zeezooX/Deshret/README.md

# Deshret
A micromouse running on a STM32 with very small dimensions and weight, and high speed and maneuverability. Its objective is to solve micromouse mazes autonomously.

## Images
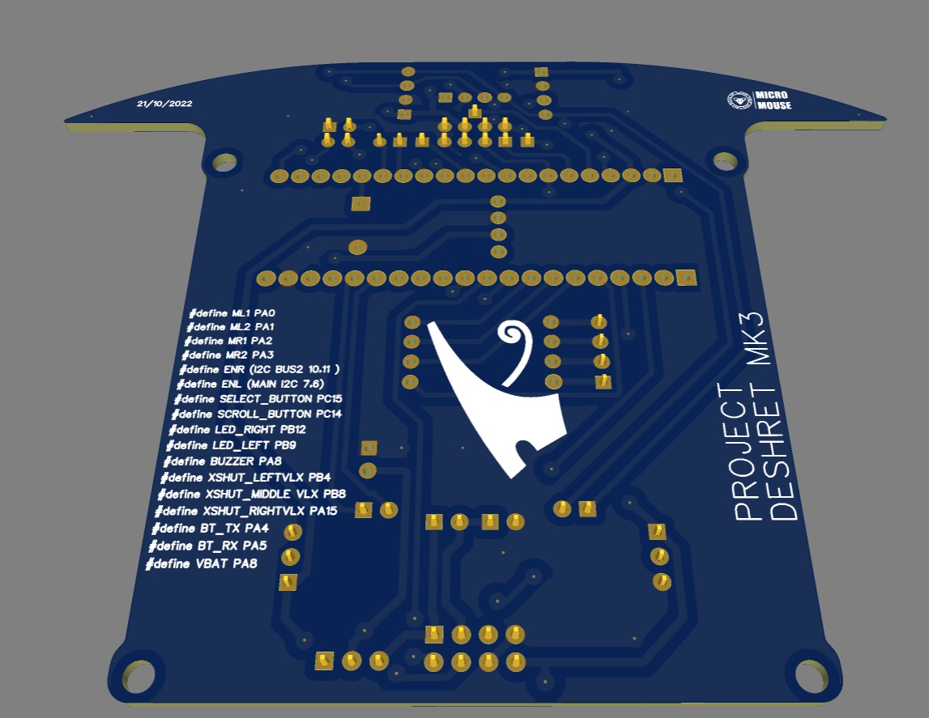
[picture p1: img/1.jpg]

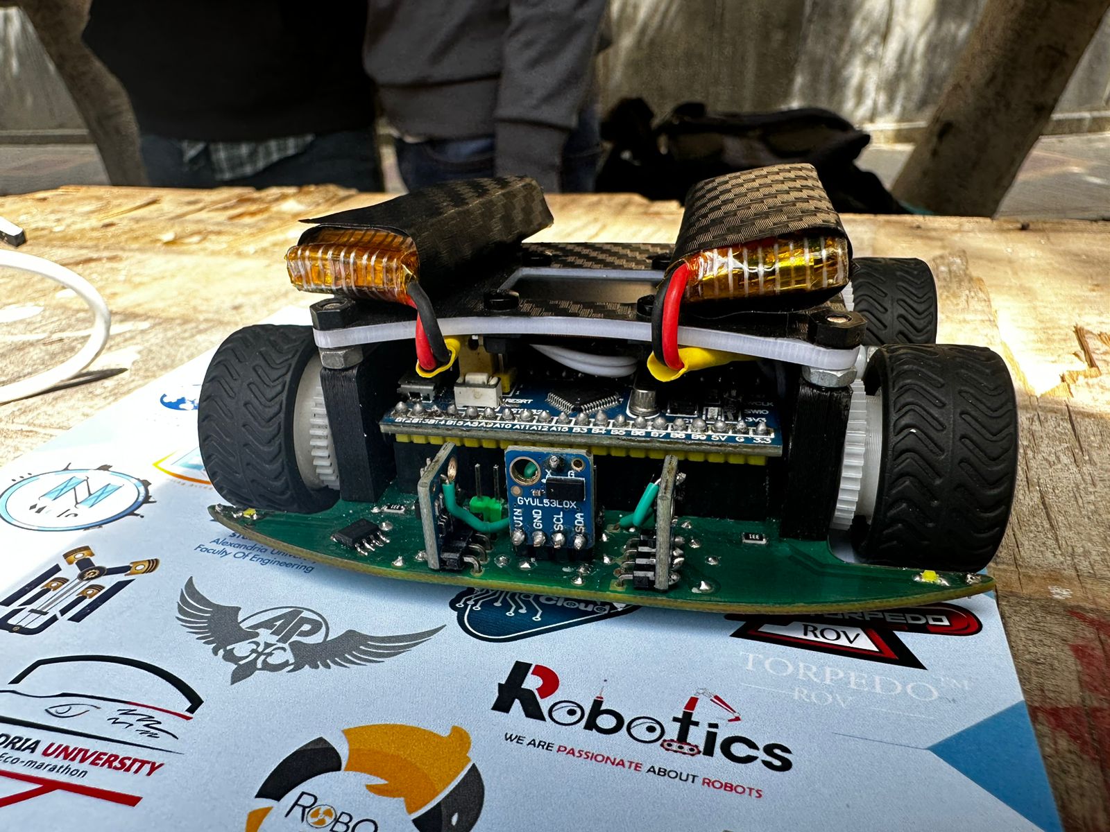
[picture p2: img/2.jpg]

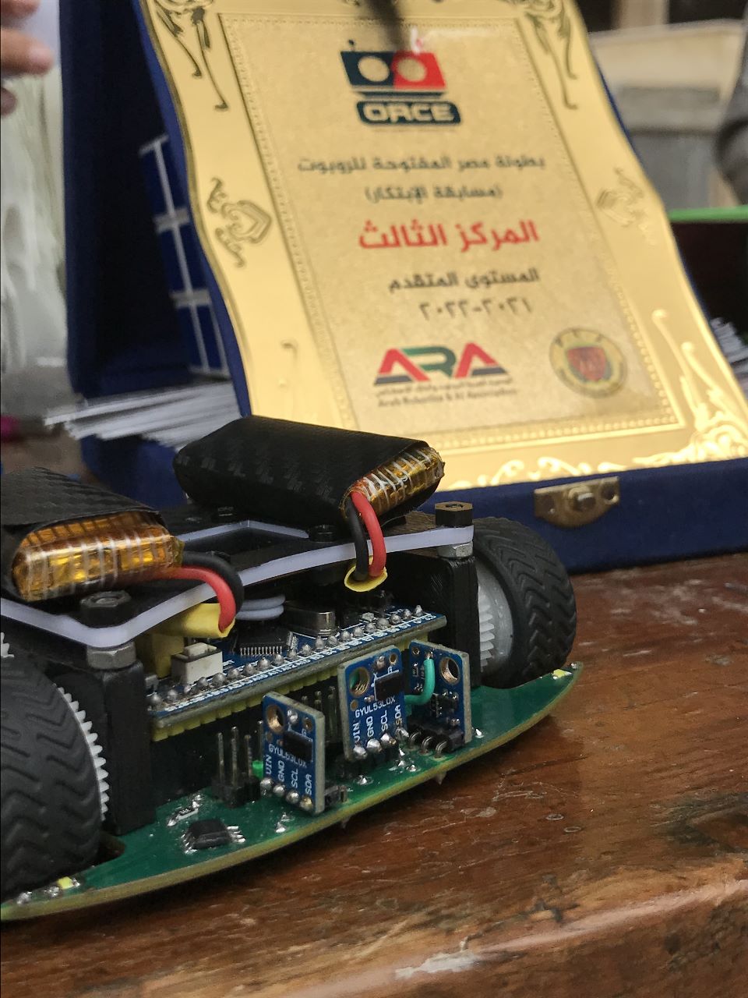
[picture p3: img/3.jpg]

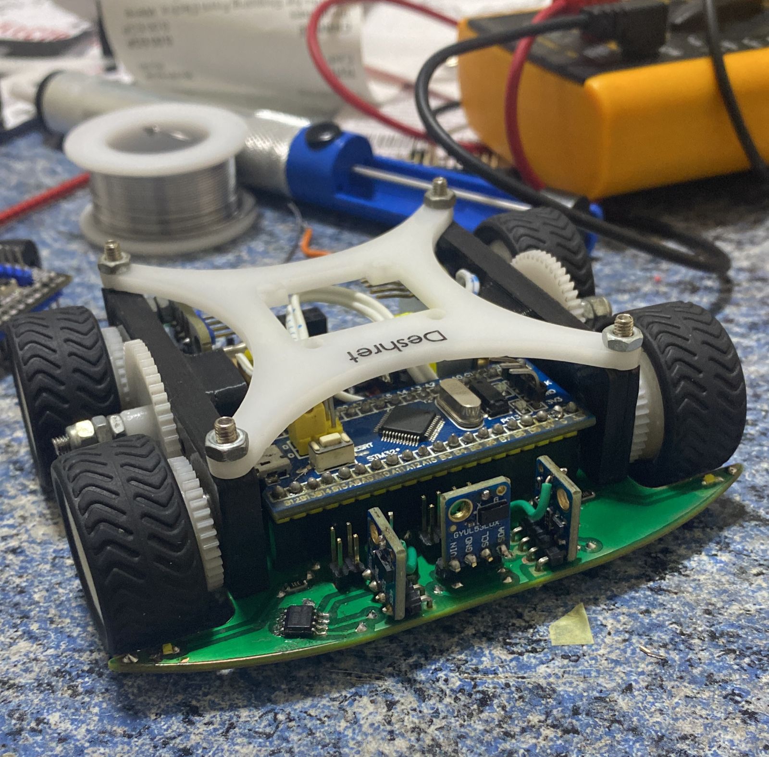
[picture p4: img/4.jpg]

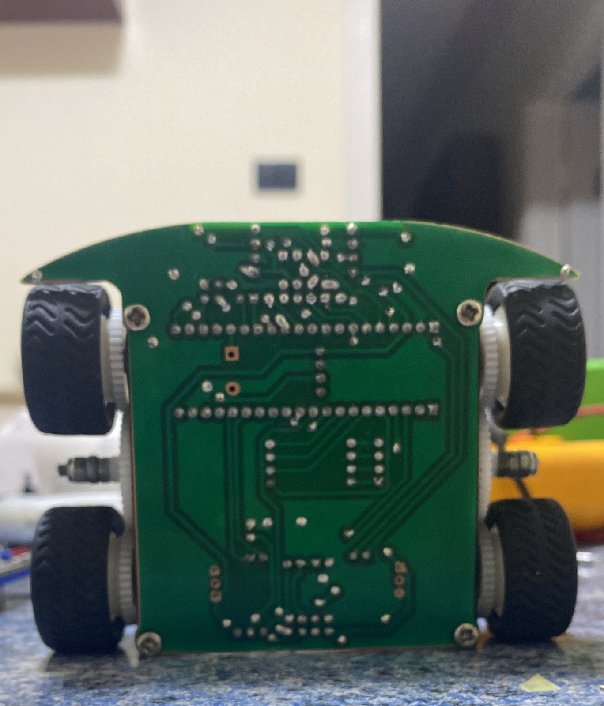
[picture p5: img/5.jpg]
