zeezooX/Deshret/doc/schematic.pdf

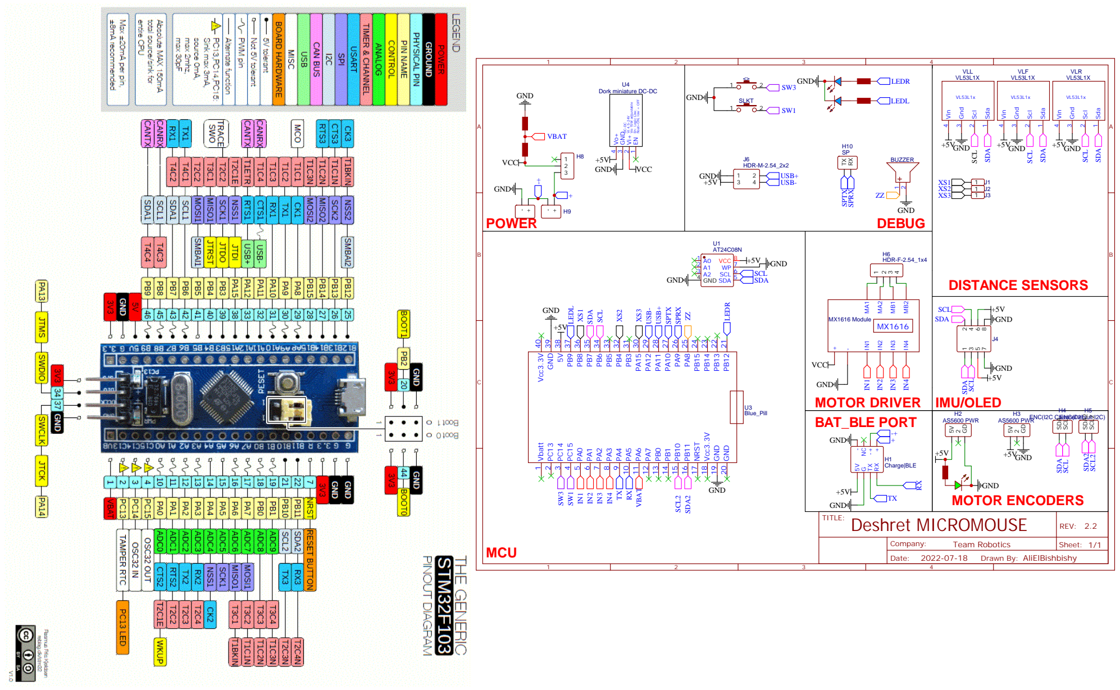
[picture p26: page 1]

Dork miniature DC-DC

float=ON, low = OFF
