zeezooX/Deshret/doc/pcb.pdf

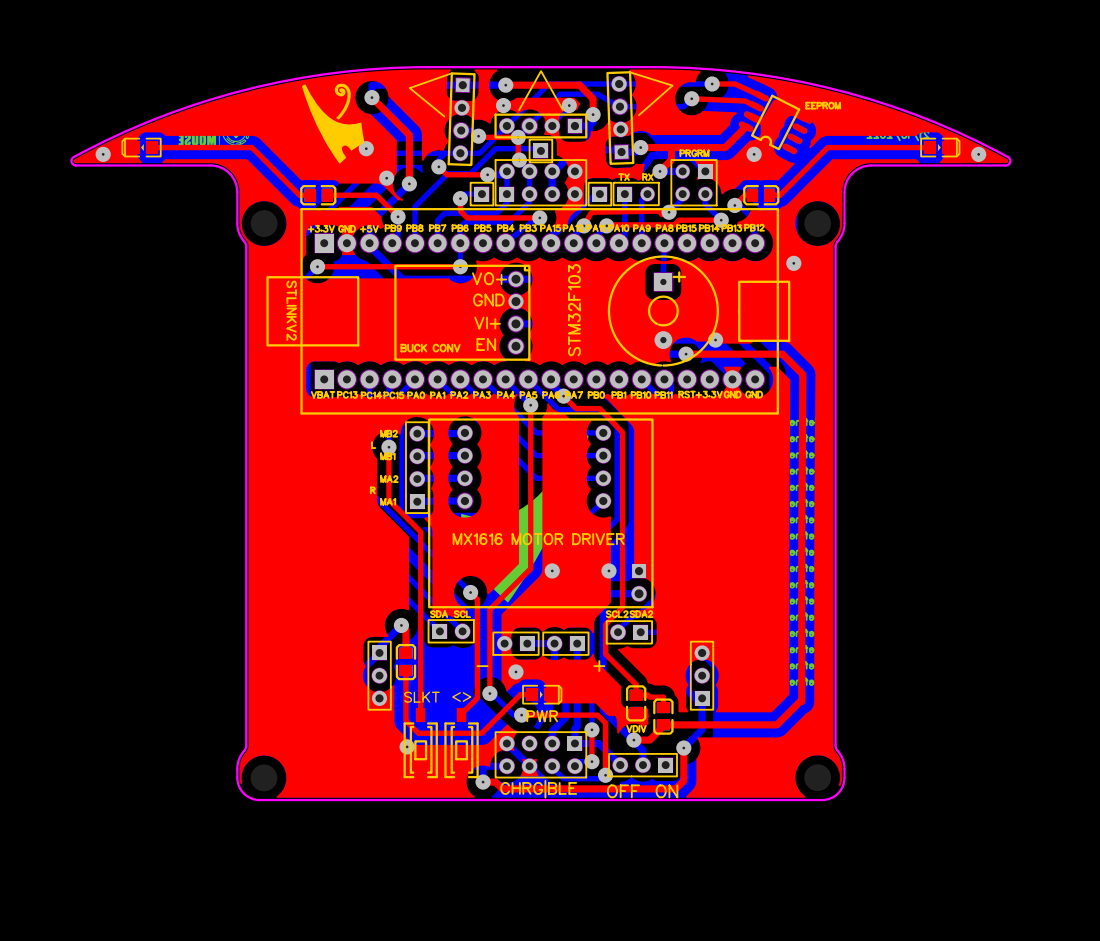
[picture p27: page 1]
